lagrandecode/beat-buddy/photos/board_back.jpg

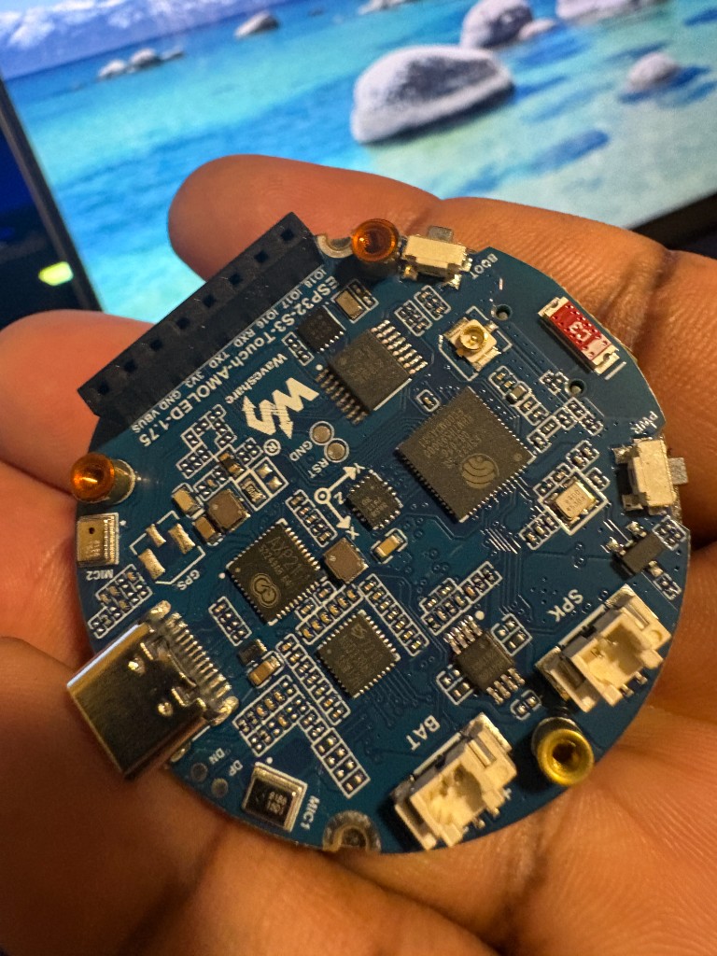
photos/board_back.jpg
