lagrandecode/beat-buddy/photos/screen_front.jpg

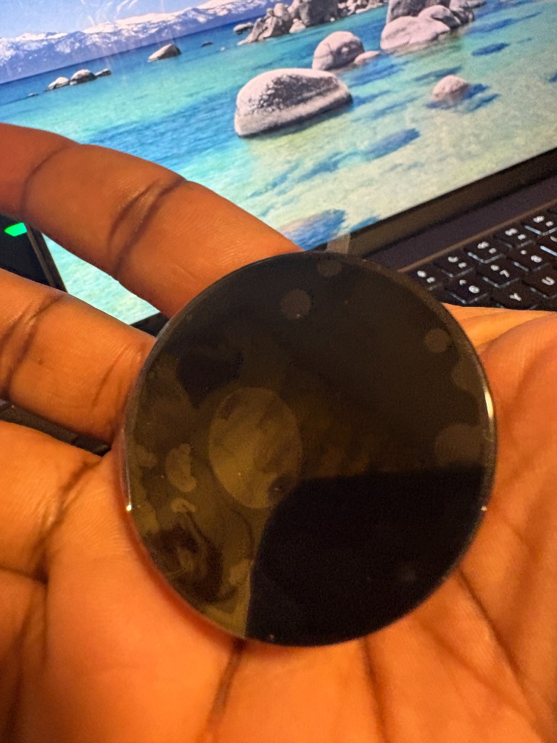
photos/screen_front.jpg
