lagrandecode/beat-buddy/photos/speaker.jpg

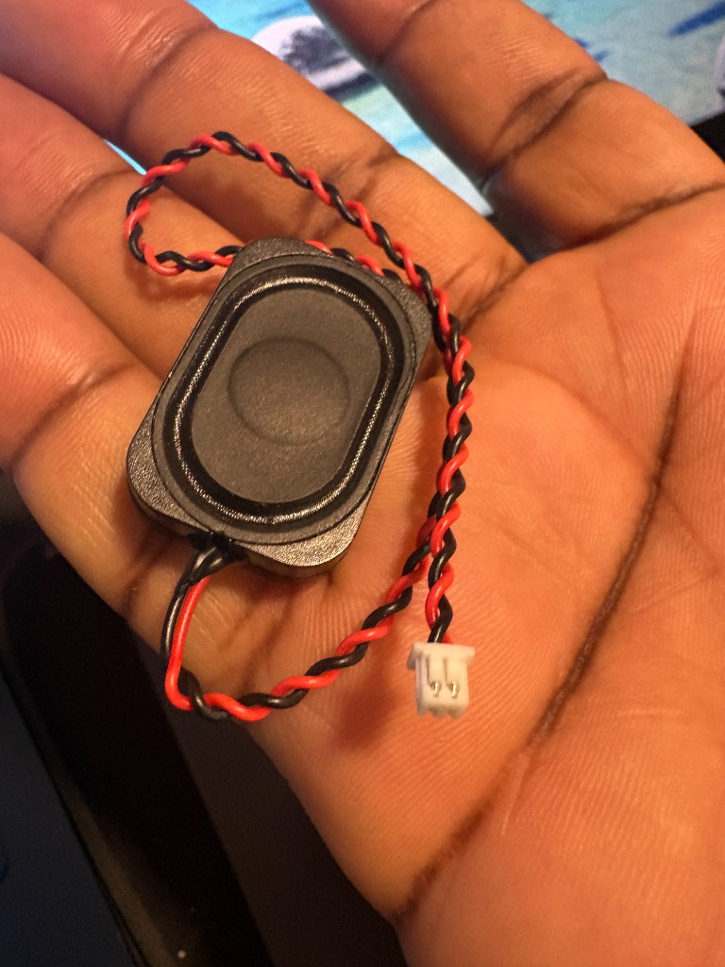
photos/speaker.jpg
