lagrandecode/beat-buddy/photos/speaker_plug.jpg

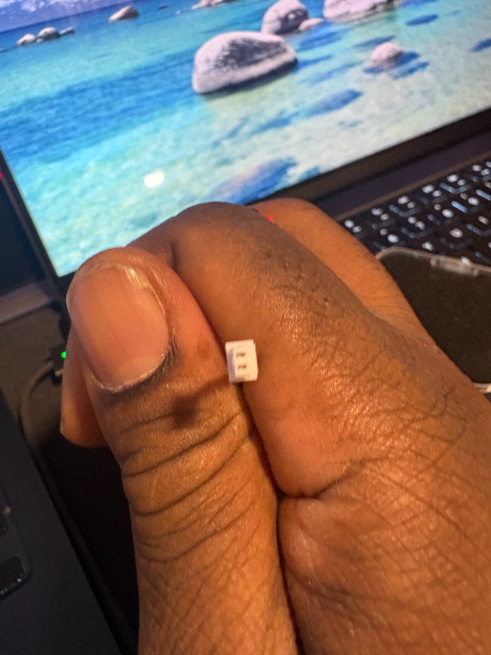
photos/speaker_plug.jpg
