lagrandecode/beat-buddy/print/beat_buddy_ALL_PARTS.3mf

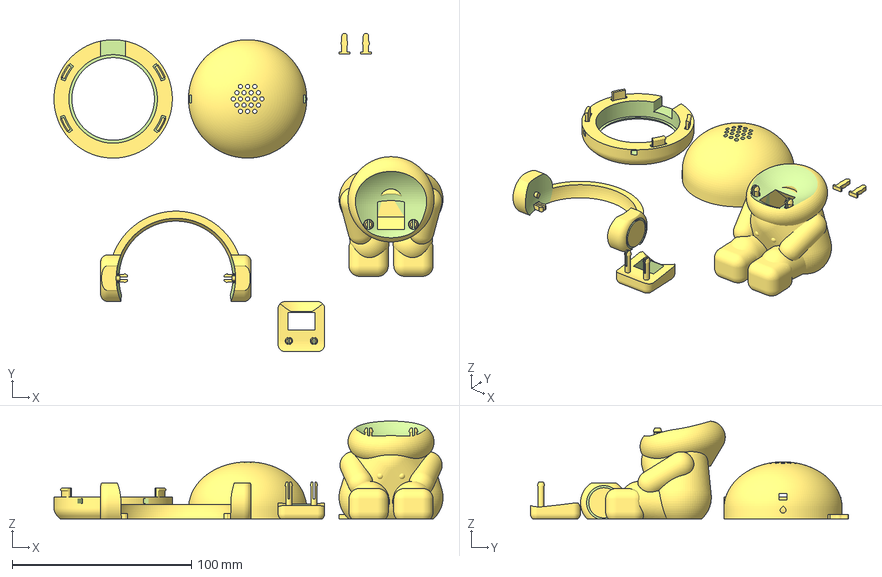
[picture p13: CAD file, 2026-11-14]
print/beat_buddy_ALL_PARTS.3mf
217.0 x 177.6 x 54.6 mm
Head front (white)
Head back (white)
Button PWR (white)
Button BOOT (white)
Body (hoodie colour)
Headphones (black)
Backpack (black)
