lagrandecode/beat-buddy/print/beat_buddy_WHITE_plate.3mf

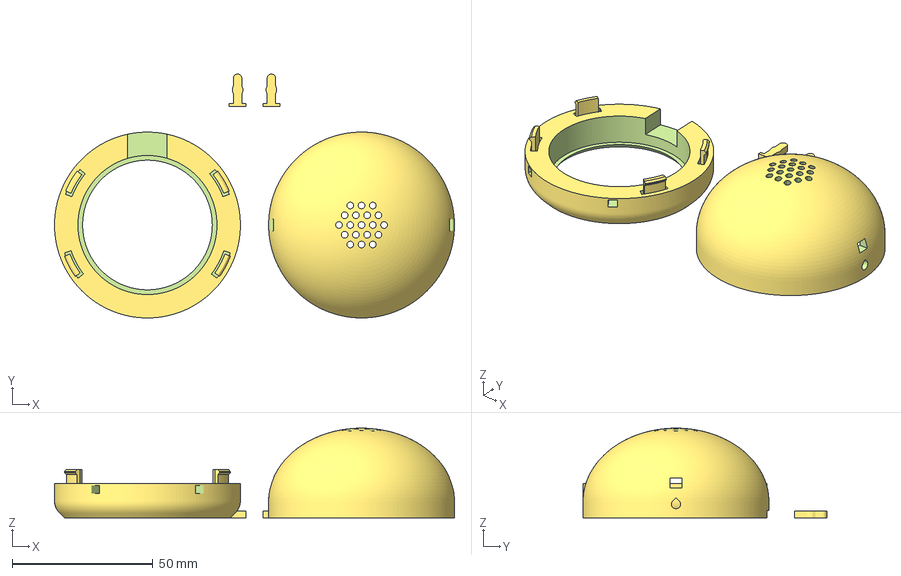
[picture p14: CAD file, 2026-11-14]
print/beat_buddy_WHITE_plate.3mf
142.0 x 86.6 x 31.8 mm
