lagrandecode/beat-buddy/print/beat_buddy_button.stl

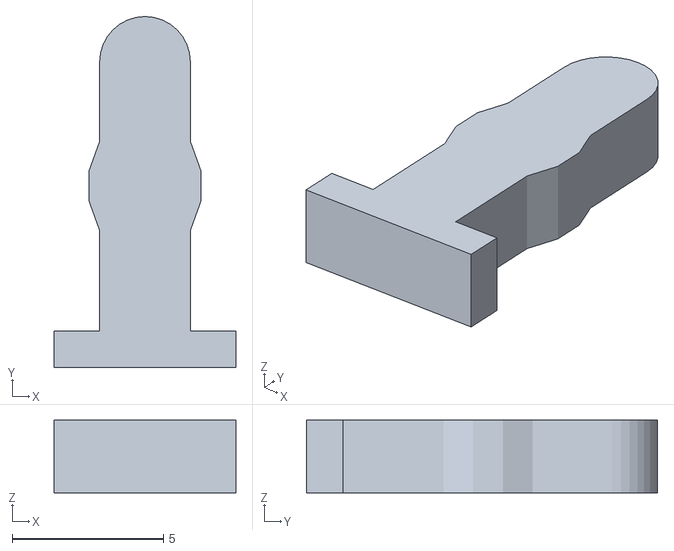
[picture p15: CAD file, 2026-11-14]
print/beat_buddy_button.stl
6.00 x 11.6 x 2.40
