lagrandecode/beat-buddy/print/beat_buddy_CLIP_TEST.3mf

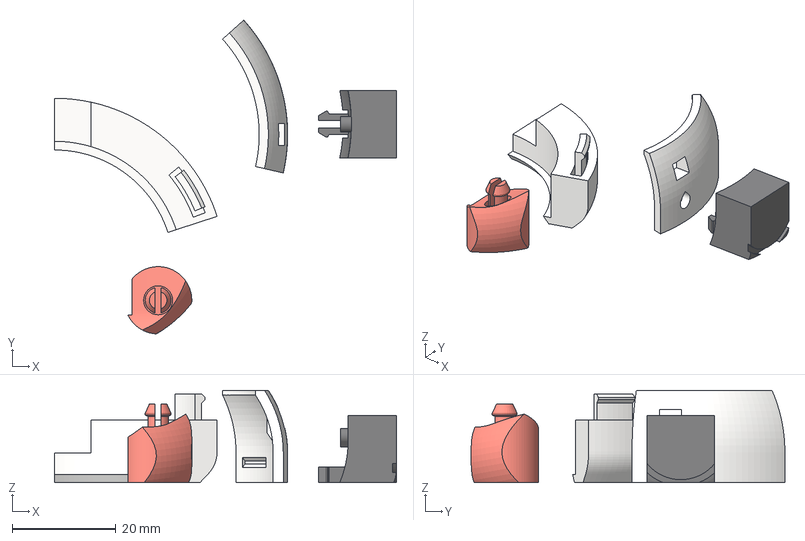
[picture p16: CAD file, 2026-11-13]
print/beat_buddy_CLIP_TEST.3mf
66.0 x 60.6 x 17.9 mm
