lagrandecode/beat-buddy/print/beat_buddy_backpack.stl

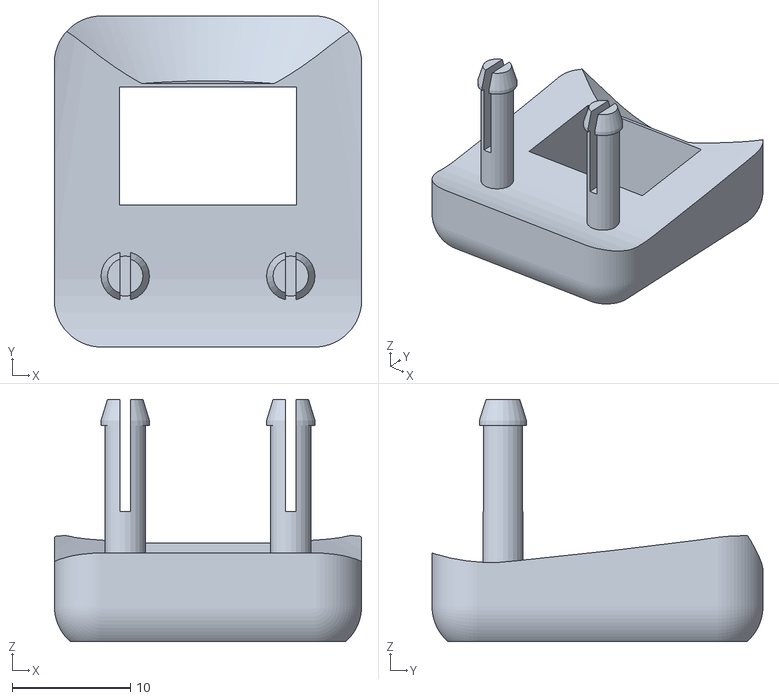
[picture p17: CAD file, 2026-11-13]
print/beat_buddy_backpack.stl
26.0 x 28.0 x 20.5
