lagrandecode/beat-buddy/print/beat_buddy_RED_plate.3mf

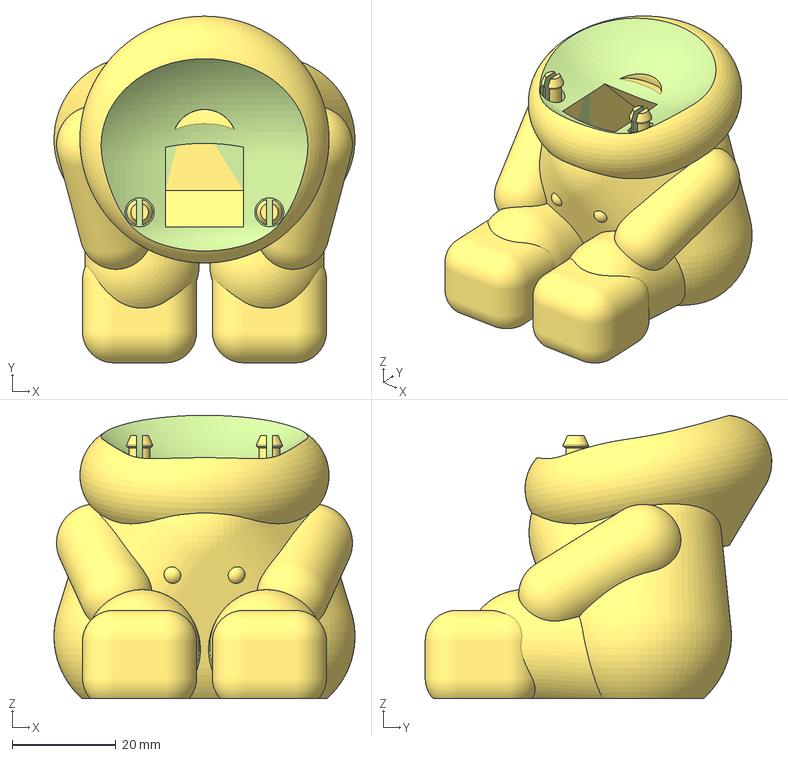
[picture p18: CAD file, 2026-11-13]
print/beat_buddy_RED_plate.3mf
58.0 x 66.8 x 54.6 mm
