lagrandecode/beat-buddy/print/beat_buddy_BLACK_plate.3mf

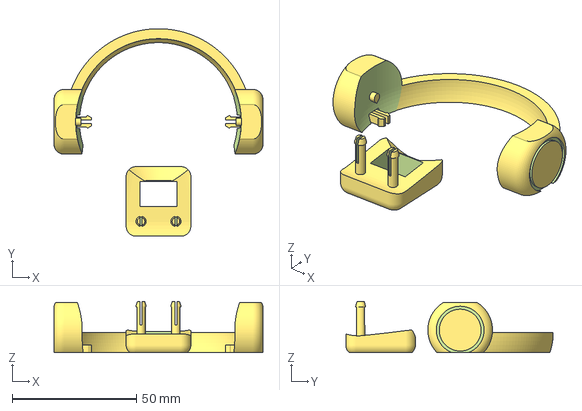
[picture p19: CAD file, 2026-11-13]
print/beat_buddy_BLACK_plate.3mf
84.0 x 83.4 x 20.5 mm
