lagrandecode/beat-buddy/print/beat_buddy_head_front.stl

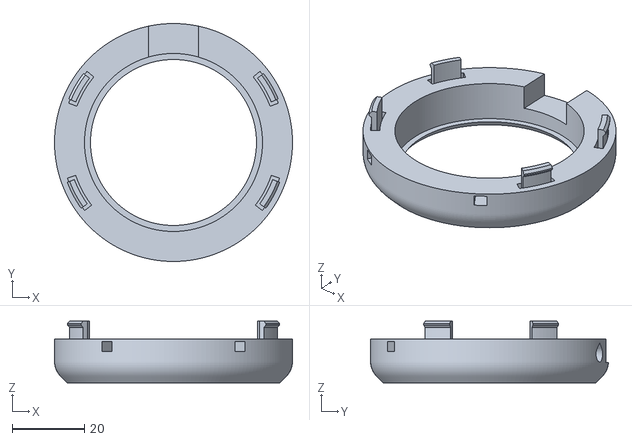
[picture p20: CAD file, 2026-11-13]
print/beat_buddy_head_front.stl
66.0 x 66.0 x 17.1
