lagrandecode/beat-buddy/print/beat_buddy_headphones.stl

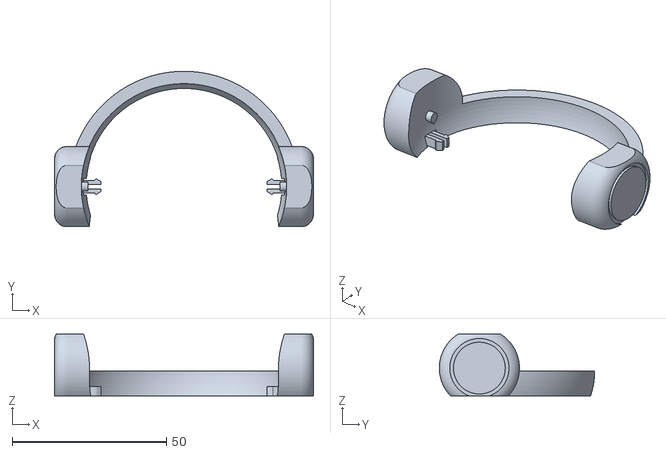
[picture p21: CAD file, 2026-11-13]
print/beat_buddy_headphones.stl
84.0 x 50.4 x 20.0
