lagrandecode/beat-buddy/print/beat_buddy_head_back.stl

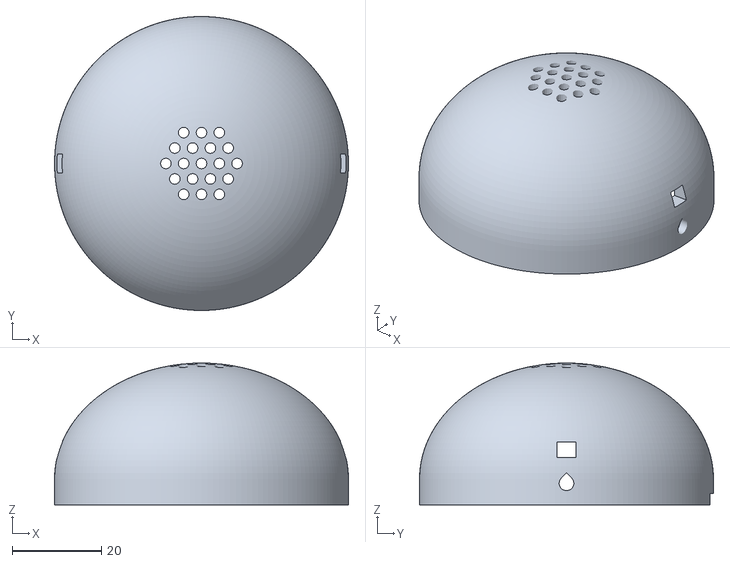
[picture p22: CAD file, 2026-11-13]
print/beat_buddy_head_back.stl
66.0 x 66.0 x 31.8
