lagrandecode/beat-buddy/(list of files, cad)

Other CAD files:
print/beat_buddy_body.stl
print/beat_buddy_CLIP_TEST.stl
