lagrandecode/beat-buddy/(commit log)

2026-11-11 Beat Buddy desk robot: OpenSCAD model, print files, renders, plan and assembly guide
    [beat_buddy.scad, beat_buddy_ALL_PARTS.3mf, beat_buddy_BLACK_plate.3mf, beat_buddy_RED_plate.3mf, beat_buddy_WHITE_plate.3mf, beat_buddy_backpack.stl, beat_buddy_band.stl, beat_buddy_body.stl]
2026-11-12 Add reference photos of the Waveshare board, screen and included speaker
2026-11-12 Add a clip-in holder for the board's 2030 box speaker; list the 500 mAh 752035 battery as an option
    [beat_buddy.scad, beat_buddy_ALL_PARTS.3mf, beat_buddy_WHITE_plate.3mf, beat_buddy_speaker_holder.stl]
2026-11-13 Redesign head: snap-fit halves, PWR/BOOT push-buttons, clip-in speaker and battery, one-piece headphones, USB-C cable through body and backpack; no glue or magnets
    [beat_buddy.scad, beat_buddy_ALL_PARTS.3mf, beat_buddy_BLACK_plate.3mf, beat_buddy_RED_plate.3mf, beat_buddy_WHITE_plate.3mf, beat_buddy_backpack.stl, beat_buddy_band.stl, beat_buddy_body.stl]
2026-11-13 Clip the head to the body and the headphones to the head with split clips; give each head hook its own pocket; correct brass post, USB-C and button positions from the Waveshare drawing; flat push-but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
    [beat_buddy.scad, beat_buddy_ALL_PARTS.3mf, beat_buddy_BLACK_plate.3mf, beat_buddy_RED_plate.3mf, beat_buddy_WHITE_plate.3mf, beat_buddy_backpack.stl, beat_buddy_body.stl, beat_buddy_button.stl]
2026-11-13 Add a 52-minute clip test print with one of every clip, cut from the real parts
    [beat_buddy.scad, beat_buddy_ALL_PARTS.3mf, beat_buddy_BLACK_plate.3mf, beat_buddy_CLIP_TEST.3mf, beat_buddy_CLIP_TEST.stl, beat_buddy_RED_plate.3mf, beat_buddy_WHITE_plate.3mf, beat_buddy_backpack.stl]
2026-11-14 Add grip ribs to the PWR/BOOT push-buttons so they stay put when the robot is turned over
    [beat_buddy.scad, beat_buddy_ALL_PARTS.3mf, beat_buddy_WHITE_plate.3mf, beat_buddy_button.stl]
2026-11-14 Add the eyes firmware and a Gemini token function so the robot can animate without the API key on the board.
